geckotronic/powerMeterDC/icons.h

// Footer icons, 22x22 RGB565, composited over COL_BG (0x0021).
// Generated from the user's PNG art with ffmpeg (rgb565le raw -> array).
#pragma once
#include <Arduino.h>
const uint16_t ICON_TEMP[484] PROGMEM = {
0x0020,0x0041,0x0020,0x0041,0x0020,0x0041,0x0020,0x0041,
0x0820,0x0021,0x41e7,0x3a08,0x0820,0x0021,0x0020,0x0041,
0x0020,0x0041,0x0020,0x0041,0x0020,0x0041,0x0021,0x0021,
0x0021,0x0021,0x0021,0x0021,0x0021,0x0021,0x0021,0xa535,
0xe77e,0xe77d,0x9d35,0x0000,0x0021,0x0021,0x0021,0x0021,
0x0021,0x0021,0x0021,0x0021,0x0020,0x0041,0x0020,0x0041,
0x0020,0x0041,0x0020,0x0041,0x3185,0xdf1c,0x4a49,0x4a49,
0xdefb,0x2986,0x0020,0x0041,0x0020,0x0041,0x0020,0x0041,
0x0020,0x0041,0x0021,0x0021,0x0021,0x0021,0x0021,0x0021,
0x0021,0x0021,0x31e8,0xad96,0x94d3,0x9cb3,0xad96,0x39e7,
0x0021,0x0021,0x0021,0x0021,0x0021,0x0021,0x0021,0x0021,
0x0020,0x0041,0x0020,0x0041,0x0020,0x0041,0x0020,0x0041,
0x6b4c,0xad96,0x9cd2,0x9cd3,0xb595,0x39e8,0x0020,0x0041,
0x0020,0x0041,0x0020,0x0041,0x0020,0x0041,0x0021,0x0021,
0x0021,0x0021,0x0021,0x0021,0x0021,0x0021,0x5b2d,0xad76,
0x94d3,0x9cb3,0xad96,0x39e7,0x0021,0x0021,0x0021,0x0021,
0x0021,0x0021,0x0021,0x0021,0x0020,0x0041,0x0020,0x0041,
0x0020,0x0041,0x0020,0x0041,0x39e7,0xad96,0x5269,0x528a,
0xb595,0x39e8,0x0020,0x0041,0x0020,0x0041,0x0020,0x0041,
0x0020,0x0041,0x0021,0x0021,0x0021,0x0021,0x0021,0x0021,
0x0021,0x0021,0x31e8,0xad76,0x7841,0x7820,0xad96,0x39e7,
0x0021,0x0021,0x0021,0x0021,0x0021,0x0021,0x0021,0x0021,
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
0x0020,0x0041,0x0020,0x0041,0x0020,0x0041,0x0021,0x0021,
0x0021,0x0021,0x0021,0x0021,0x2125,0xdebb,0xef7e,0x8c10,
0xb481,0xb460,0x8431,0xf75d,0xc639,0x20e4,0x0021,0x0021,
0x0021,0x0021,0x0021,0x0021,0x0020,0x0041,0x0020,0x0041,
0x0820,0x0020,0x4a04,0x4a46,0x6260,0x8383,0xfe80,0xfe80,
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

};
