geckotronic/powerMeterDC/(commit log)

2026-08-05 feat: DC power meter for 4S LiFePO4 pack (ESP32-C3 + ST7789 + INA226)
2026-08-12 feat: migrate display to Waveshare 2.13in e-paper with partial refresh
    - GxEPD2 (GxEPD2_213_BN) replaces Adafruit ST7789; new SPI pinout with BUSY
    - redraw only when displayed content changes; full refresh at boot and every 10 min
    - charge/discharge arrows beside the watts value; uptime clock with per-refresh colon blink
    - chart, icons and color palette removed; README updated for the new hardware
    [powerMeterDC.ino]
